tomverbeure/ds1486/ds1486_rp2350/ds1486_rp2350.kicad_pcb

## KiCad design ds1486_rp2350/ds1486_rp2350.kicad_pcb (2025-09-17)

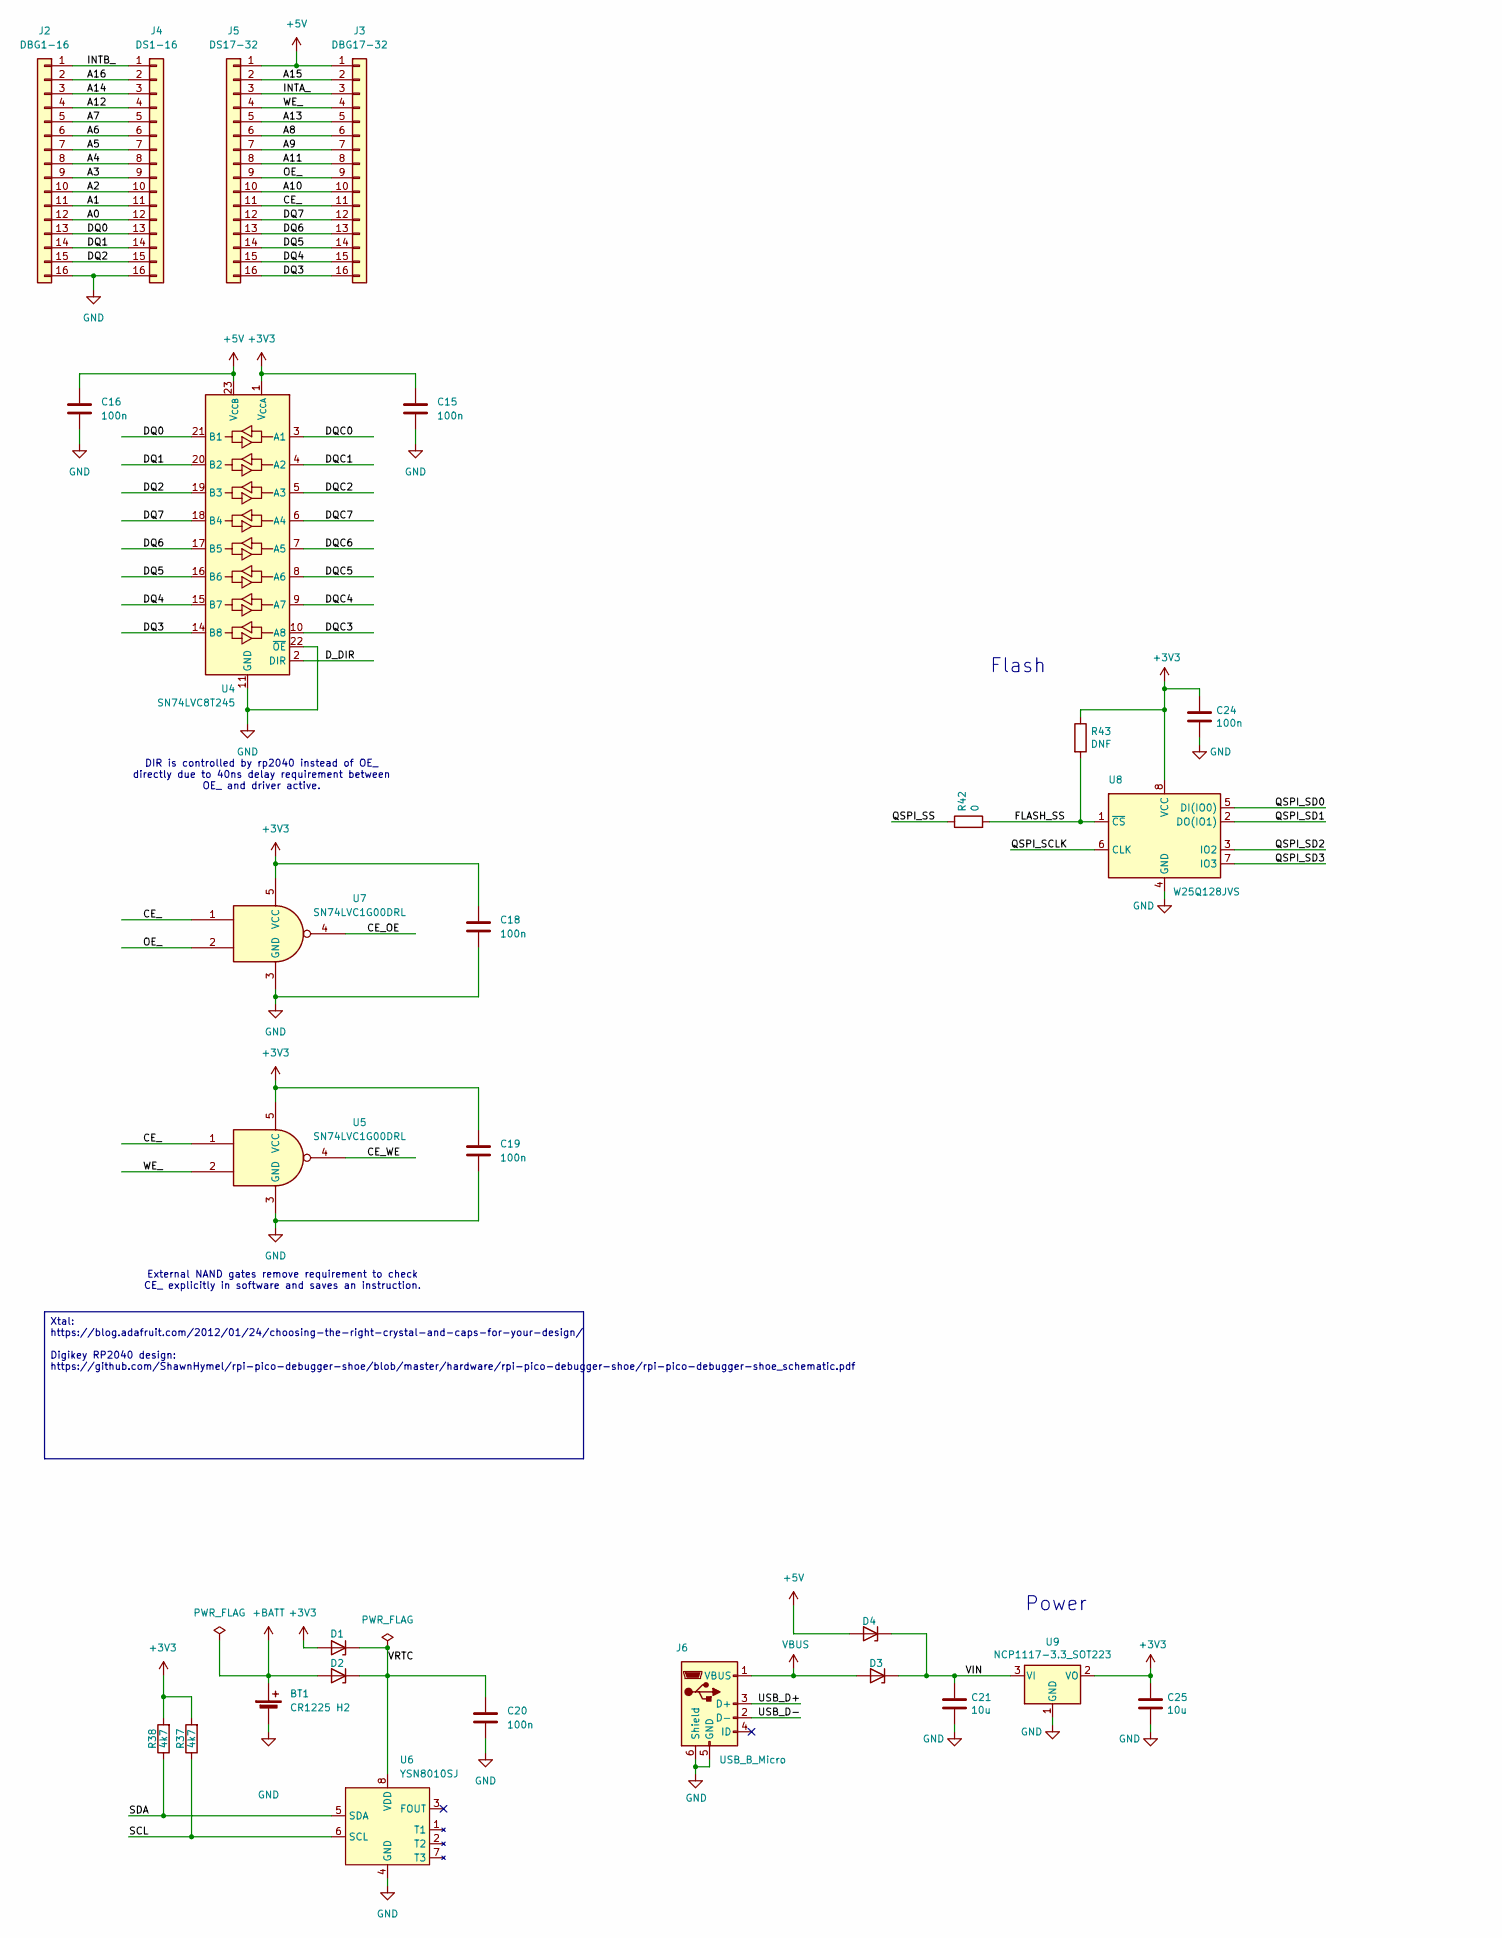
[picture p1: schematic ds1486_rp2350.kicad_sch, part in row 1, column 1]

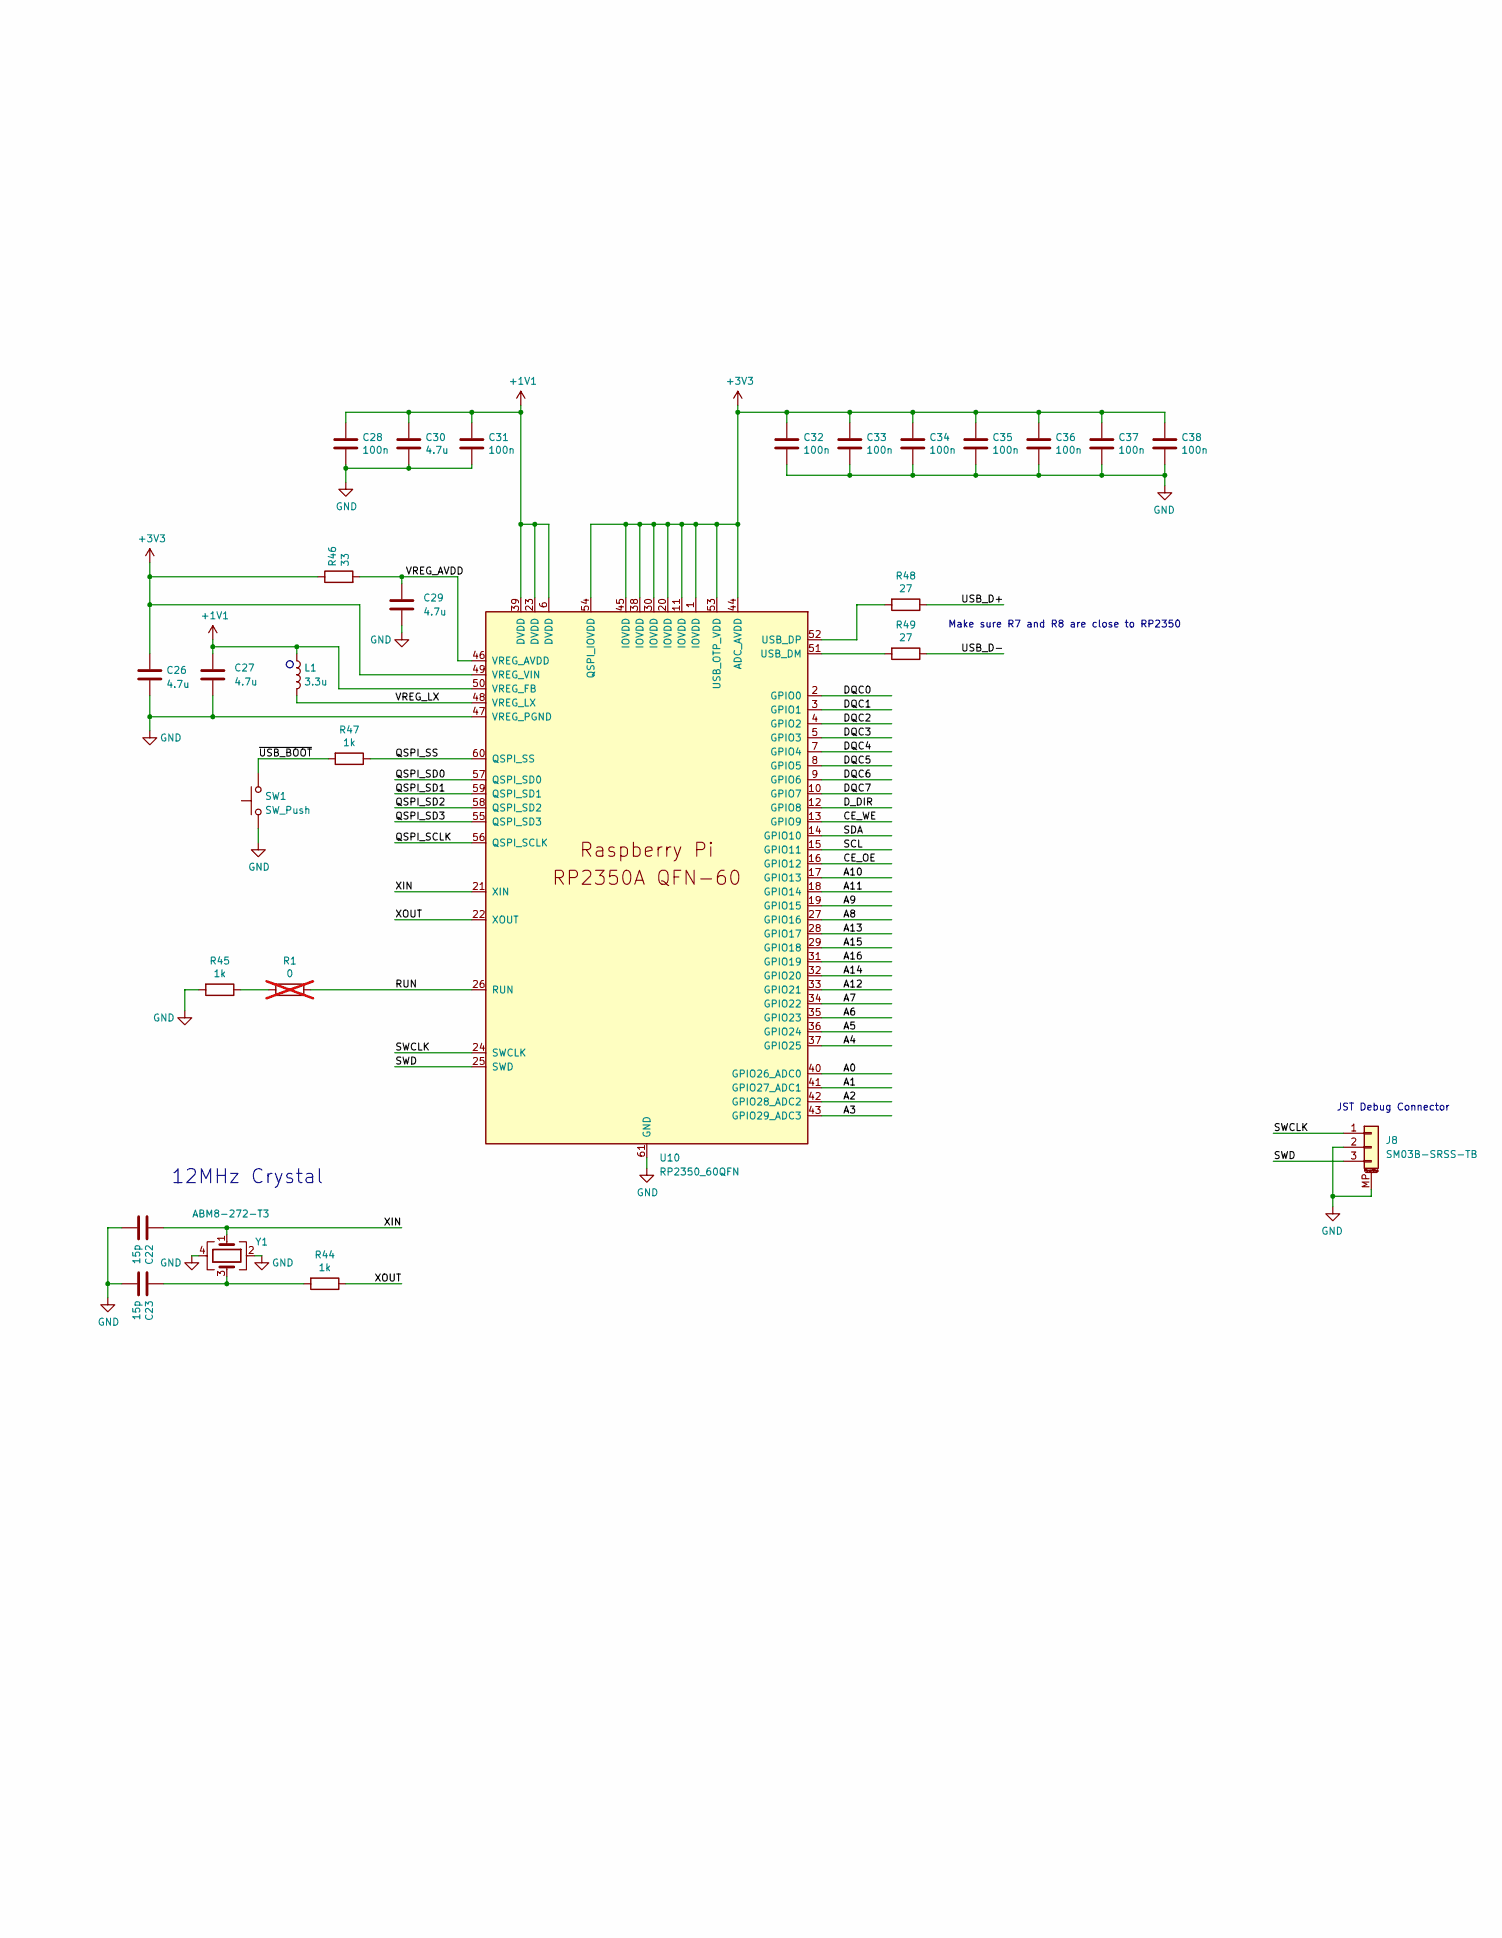
[picture p2: schematic ds1486_rp2350.kicad_sch, part in row 1, column 2]

Parts:
BT1: CR1225 H2; CR1225_H2
C15, C16, C20: 100n; C_0603_1608Metric
C18, C19, C24, C28, C31, C32, C33, C34, C35, C36, C37, C38: 100n; C_0402_1005Metric
C21, C25: 10u; C_0805_2012Metric
C22, C23: 15p; C_0402_1005Metric
C26, C27: 4.7u; C_0402_1005Metric_small_pads
C29, C30: 4.7u; C_0402_1005Metric
D1, D2, D3, D4: BZT52C6V8-7-F; D_SOD-123F
J2: DBG1-16; PinHeader_1x16_P2.54mm_Vertical
J3: DBG17-32; PinHeader_1x16_P2.54mm_Vertical
J4: DS1-16; PinHeader_1x16_P2.54mm_Vertical_DIP_Diameter_Flipside
J5: DS17-32; PinHeader_1x16_P2.54mm_Vertical_DIP_Diameter_Flipside
J6: USB_B_Micro; USB_Micro-B_Amphenol_10103594-0001LF_Horizontal
J8: SM03B-SRSS-TB; JST_SH_SM03B-SRSS-TB_1x03-1MP_P1.00mm_Horizontal
L1: 3.3u; L_pol_2016
R1: 0; R_0402_1005Metric; not fitted
R37, R38: 4k7; R_0402_1005Metric
R42: 0; R_0402_1005Metric
R43: DNF; R_0402_1005Metric
R44, R45, R47: 1k; R_0402_1005Metric
R46: 33; R_0402_1005Metric
R48, R49: 27; R_0402_1005Metric
SW1: SW_Push; SW_Push_1P1T_NO_Vertical_Wuerth_434133025816
U4: SN74LVC8T245; SSOP-24_3.9x8.7mm_P0.635mm
U5, U7: SN74LVC1G00DRL; Texas_R-PDSO-N5_DRL-5
U6: YSN8010SJ; SOP-8_3.9x4.9mm_P1.27mm
U8: W25Q128JVS; SOIC-8_5.23x5.23mm_P1.27mm
U9: NCP1117-3.3_SOT223; SOT-223-3_TabPin2
U10: RP2350_60QFN; QFN-60-1EP_7x7mm_P0.4mm_EP3.4x3.4mm
Y1: ABM8-272-T3; Crystal_SMD_3225-4Pin_3.2x2.5mm

Connections:
+1V1: C27.1, C28.1, C30.1, C31.1, L1.1, U10.6 (DVDD), U10.23 (DVDD), U10.39 (DVDD), U10.50 (VREG_FB)
+3V3: C15.1, C18.1, C19.1, C24.1, C25.1, C26.1, C32.1, C33.1, C34.1, C35.1, C36.1, C37.1, C38.1, D1.2 (A), R37.2, R38.2, R43.1, R46.1, U4.1 (V_{CCA}), U5.5 (VCC), U7.5 (VCC), U8.8 (VCC), U9.2 (VO), U10.1 (IOVDD), U10.11 (IOVDD), U10.20 (IOVDD), U10.30 (IOVDD), U10.38 (IOVDD), U10.44 (ADC_AVDD), U10.45 (IOVDD), U10.49 (VREG_VIN), U10.53 (USB_OTP_VDD), U10.54 (QSPI_IOVDD)
+5V: C16.1, D4.2 (A), J3.1, J5.1, U4.23 (V_{CCB}), U4.24 (V_{CCB})
+BATT: BT1.1 (+), D2.2 (A)
/A0: J2.12, J4.12, U10.40 (GPIO26_ADC0)
/A1: J2.11, J4.11, U10.41 (GPIO27_ADC1)
/A2: J2.10, J4.10, U10.42 (GPIO28_ADC2)
/A3: J2.9, J4.9, U10.43 (GPIO29_ADC3)
/A4: J2.8, J4.8, U10.37 (GPIO25)
/A5: J2.7, J4.7, U10.36 (GPIO24)
/A6: J2.6, J4.6, U10.35 (GPIO23)
/A7: J2.5, J4.5, U10.34 (GPIO22)
/A8: J3.6, J5.6, U10.27 (GPIO16)
/A9: J3.7, J5.7, U10.19 (GPIO15)
/A10: J3.10, J5.10, U10.17 (GPIO13)
/A11: J3.8, J5.8, U10.18 (GPIO14)
/A12: J2.4, J4.4, U10.33 (GPIO21)
/A13: J3.5, J5.5, U10.28 (GPIO17)
/A14: J2.3, J4.3, U10.32 (GPIO20)
/A15: J3.2, J5.2, U10.29 (GPIO18)
/A16: J2.2, J4.2, U10.31 (GPIO19)
/CE_: J3.11, J5.11, U5.1, U7.1
/CE_OE: U7.4, U10.16 (GPIO12)
/CE_WE: U5.4, U10.13 (GPIO9)
/DQ0: J2.13, J4.13, U4.21 (B1)
/DQ1: J2.14, J4.14, U4.20 (B2)
/DQ2: J2.15, J4.15, U4.19 (B3)
/DQ3: J3.16, J5.16, U4.14 (B8)
/DQ4: J3.15, J5.15, U4.15 (B7)
/DQ5: J3.14, J5.14, U4.16 (B6)
/DQ6: J3.13, J5.13, U4.17 (B5)
/DQ7: J3.12, J5.12, U4.18 (B4)
/DQC0: U4.3 (A1), U10.2 (GPIO0)
/DQC1: U4.4 (A2), U10.3 (GPIO1)
/DQC2: U4.5 (A3), U10.4 (GPIO2)
/DQC3: U4.10 (A8), U10.5 (GPIO3)
/DQC4: U4.9 (A7), U10.7 (GPIO4)
/DQC5: U4.8 (A6), U10.8 (GPIO5)
/DQC6: U4.7 (A5), U10.9 (GPIO6)
/DQC7: U4.6 (A4), U10.10 (GPIO7)
/D_DIR: U4.2 (DIR), U10.12 (GPIO8)
/FLASH_SS: R42.2, R43.2, U8.1 (~CS)
/INTA_: J3.3, J5.3
/INTB_: J2.1, J4.1
/OE_: J3.9, J5.9, U7.2
/QSPI_SCLK: U8.6 (CLK), U10.56 (QSPI_SCLK)
/QSPI_SD0: U8.5 (DI(IO0)), U10.57 (QSPI_SD0)
/QSPI_SD1: U8.2 (DO(IO1)), U10.59 (QSPI_SD1)
/QSPI_SD2: U8.3 (IO2), U10.58 (QSPI_SD2)
/QSPI_SD3: U8.7 (IO3), U10.55 (QSPI_SD3)
/QSPI_SS: R42.1, R47.1, U10.60 (QSPI_SS)
/RUN: R1.1, U10.26 (RUN)
/SCL: R37.1, U6.6 (SCL), U10.15 (GPIO11)
/SDA: R38.1, U6.5 (SDA), U10.14 (GPIO10)
/SWCLK: J8.1, U10.24 (SWCLK)
/SWD: J8.3, U10.25 (SWD)
/USB_D+: J6.3 (D+), R48.1
/USB_D-: J6.2 (D-), R49.1
/VIN: C21.1, D3.1 (K), D4.1 (K), U9.3 (VI)
/VREG_AVDD: C29.1, R46.2, U10.46 (VREG_AVDD)
/VREG_LX: L1.2, U10.48 (VREG_LX)
/VRTC: C20.1, D1.1 (K), D2.1 (K), U6.8 (VDD)
/WE_: J3.4, J5.4, U5.2
/XIN: C22.1, U10.21 (XIN), Y1.1
/XOUT: R44.1, U10.22 (XOUT)
/~USB_BOOT: R47.2, SW1.2
GND: BT1.2 (-), C15.2, C16.2, C18.2, C19.2, C20.2, C21.2, C22.2, C23.2, C24.2, C25.2, C26.2, C27.2, C28.2, C29.2, C30.2, C31.2, C32.2, C33.2, C34.2, C35.2, C36.2, C37.2, C38.2, J2.16, J4.16, J6.5 (GND), J6.6 (Shield), J8.2, J8.MP (MountPin), R45.2, SW1.1, U4.11 (GND), U4.12 (GND), U4.13 (GND), U4.22 (~OE), U5.3 (GND), U6.4 (GND), U7.3 (GND), U8.4 (GND), U9.1 (GND), U10.47 (VREG_PGND), U10.61 (GND), Y1.2, Y1.4
unnamed: C23.1, R44.2, Y1.3
unnamed: R1.2, R45.1
unnamed: R49.2, U10.51 (USB_DM)
unnamed: R48.2, U10.52 (USB_DP)
VBUS: D3.2 (A), J6.1 (VBUS)

Notes on the sheet:
Flash
DIR is controlled by rp2040 instead of OE_ directly due to 40ns delay requirement between OE_ and driver active.
External NAND gates remove requirement to check CE_ explicitly in software and saves an instruction.
12MHz Crystal
Make sure R7 and R8 are close to RP2350
Power
JST Debug Connector
Xtal: https://blog.adafruit.com/2012/01/24/choosing-the-right-crystal-and-caps-for-your-design/ Digikey RP2040 design: https://github.com/ShawnHymel/rpi-pico-debugger-shoe/blob/master/hardware/rpi-pico-debugger-shoe/rpi-pico-debugger-shoe_schematic.pdf

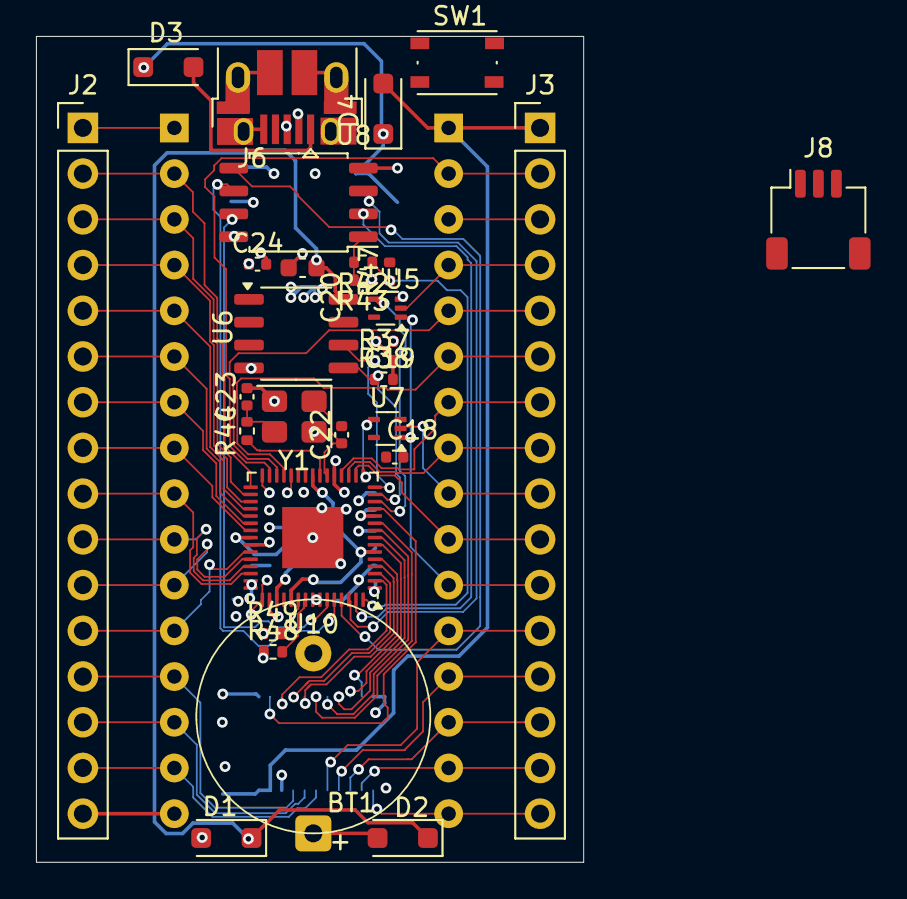
[picture p3: board ds1486_rp2350.kicad_pcb from above]

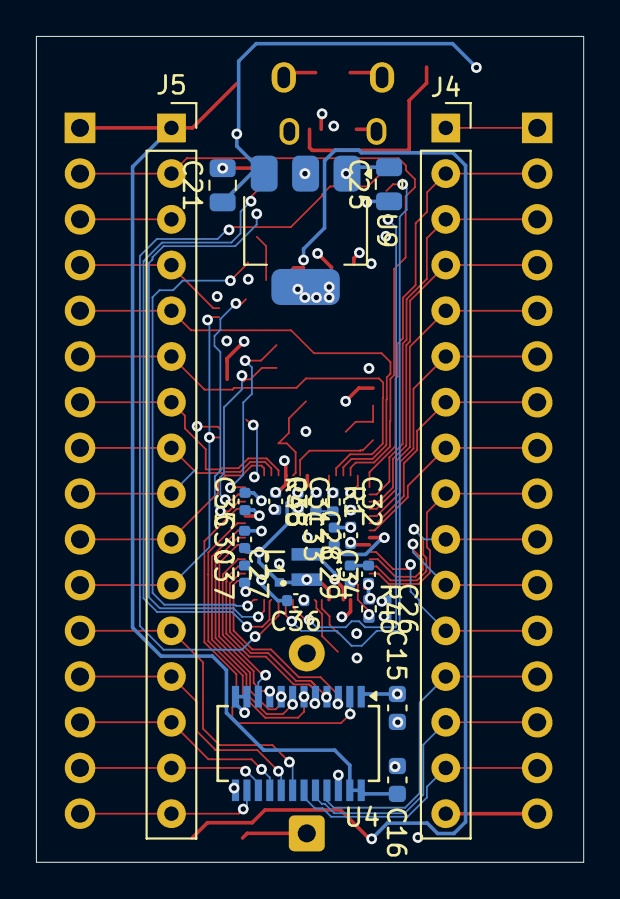
[picture p4: board ds1486_rp2350.kicad_pcb from below]

Board: 4 copper layers, 30.4 x 45.9 mm, 55 parts (23 on the bottom side), 72 nets.
