tomverbeure/ds1486/ds1486/ds1486.kicad_pcb

## KiCad design ds1486/ds1486.kicad_pcb (2025-06-24)

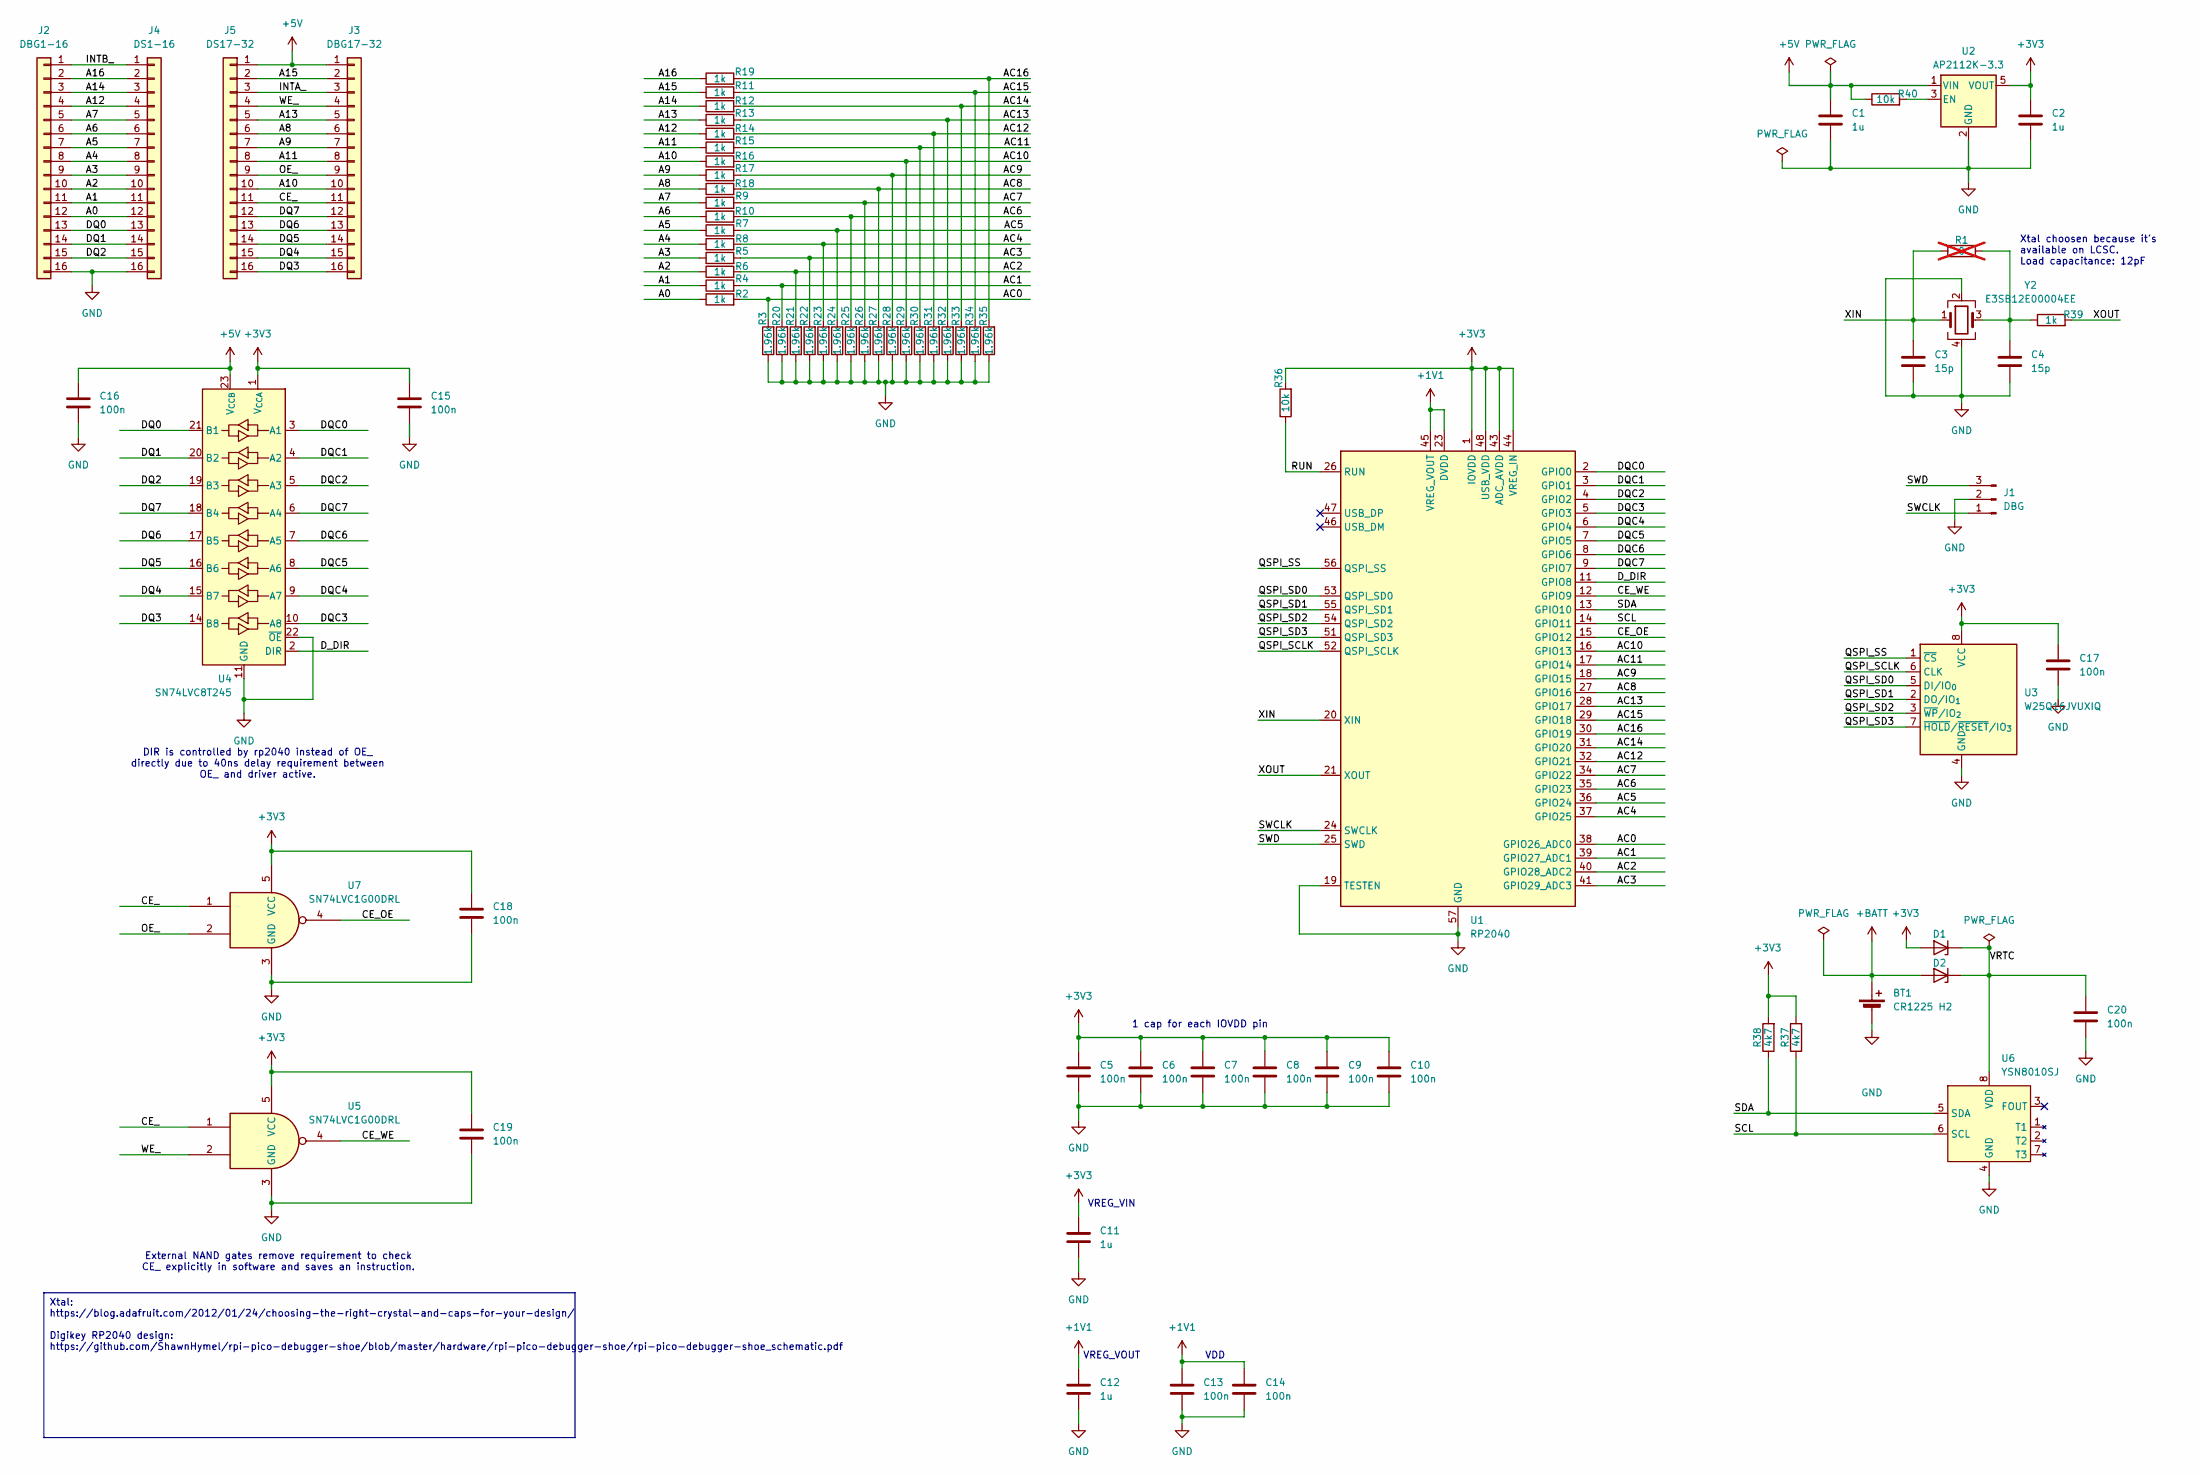
[picture p5: schematic ds1486.kicad_sch]

Parts:
BT1: CR1225 H2; CR1225_H2
C1, C2, C11, C12: 1u; C_0603_1608Metric
C3, C4: 15p; C_0603_1608Metric
C5, C6, C7, C8, C9, C10, C13, C14, C15, C16, C17, C20: 100n; C_0603_1608Metric
C18, C19: 100n; C_0402_1005Metric
D1, D2: BZT52C6V8-7-F; D_SOD-123F
J1: DBG; PinHeader_1x03_P2.54mm_Vertical
J2: DBG1-16; PinHeader_1x16_P2.54mm_Vertical
J3: DBG17-32; PinHeader_1x16_P2.54mm_Vertical
J4: DS1-16; PinHeader_1x16_P2.54mm_Vertical_DIP_Diameter_Flipside
J5: DS17-32; PinHeader_1x16_P2.54mm_Vertical_DIP_Diameter_Flipside
R1: 0; R_0603_1608Metric; not fitted
R2, R4, R5, R6, R7, R8, R9, R10, R11, R12, R13, R14, R15, R16, R17, R18, R19, R39: 1k; R_0402_1005Metric
R3, R20, R21, R22, R23, R24, R25, R26, R27, R28, R29, R30, R31, R32, R33, R34, R35: 1.96k; R_0402_1005Metric
R36, R40: 10k; R_0402_1005Metric
R37, R38: 4k7; R_0603_1608Metric
U1: RP2040; QFN-56-1EP_7x7mm_P0.4mm_EP3.2x3.2mm
U2: AP2112K-3.3; SOT-23-5
U3: W25Q16JVUXIQ; Winbond_USON-8-1EP_3x2mm_P0.5mm_EP0.2x1.6mm
U4: SN74LVC8T245; SSOP-24_3.9x8.7mm_P0.635mm
U5, U7: SN74LVC1G00DRL; Texas_R-PDSO-N5_DRL-5
U6: YSN8010SJ; SOP-8_3.9x4.9mm_P1.27mm
Y2: E3SB12E00004EE; Crystal_SMD_3225-4Pin_3.2x2.5mm

Connections:
+1V1: C12.1, C13.1, C14.1, U1.23 (DVDD), U1.45 (VREG_VOUT), U1.50 (DVDD)
+3V3: C2.1, C5.1, C6.1, C7.1, C8.1, C9.1, C10.1, C11.1, C15.1, C17.1, C18.1, C19.1, D1.2 (A), R36.2, R37.2, R38.2, U1.1 (IOVDD), U1.10 (IOVDD), U1.22 (IOVDD), U1.33 (IOVDD), U1.42 (IOVDD), U1.43 (ADC_AVDD), U1.44 (VREG_IN), U1.48 (USB_VDD), U1.49 (IOVDD), U2.5 (VOUT), U3.8 (VCC), U4.1 (V_{CCA}), U5.5 (VCC), U7.5 (VCC)
+5V: C1.1, C16.1, J3.1, J5.1, R40.1, U2.1 (VIN), U4.23 (V_{CCB}), U4.24 (V_{CCB})
+BATT: BT1.1 (+), D2.2 (A)
/A0: J2.12, J4.12, R2.1
/A1: J2.11, J4.11, R4.1
/A2: J2.10, J4.10, R6.1
/A3: J2.9, J4.9, R5.1
/A4: J2.8, J4.8, R8.1
/A5: J2.7, J4.7, R7.1
/A6: J2.6, J4.6, R10.1
/A7: J2.5, J4.5, R9.1
/A8: J3.6, J5.6, R18.1
/A9: J3.7, J5.7, R17.1
/A10: J3.10, J5.10, R16.1
/A11: J3.8, J5.8, R15.1
/A12: J2.4, J4.4, R14.1
/A13: J3.5, J5.5, R13.1
/A14: J2.3, J4.3, R12.1
/A15: J3.2, J5.2, R11.1
/A16: J2.2, J4.2, R19.1
/AC0: R2.2, R3.2, U1.38 (GPIO26_ADC0)
/AC1: R4.2, R20.2, U1.39 (GPIO27_ADC1)
/AC2: R6.2, R21.2, U1.40 (GPIO28_ADC2)
/AC3: R5.2, R22.2, U1.41 (GPIO29_ADC3)
/AC4: R8.2, R23.2, U1.37 (GPIO25)
/AC5: R7.2, R24.2, U1.36 (GPIO24)
/AC6: R10.2, R25.2, U1.35 (GPIO23)
/AC7: R9.2, R26.2, U1.34 (GPIO22)
/AC8: R18.2, R27.2, U1.27 (GPIO16)
/AC9: R17.2, R28.2, U1.18 (GPIO15)
/AC10: R16.2, R29.2, U1.16 (GPIO13)
/AC11: R15.2, R30.2, U1.17 (GPIO14)
/AC12: R14.2, R31.2, U1.32 (GPIO21)
/AC13: R13.2, R32.2, U1.28 (GPIO17)
/AC14: R12.2, R33.2, U1.31 (GPIO20)
/AC15: R11.2, R34.2, U1.29 (GPIO18)
/AC16: R19.2, R35.2, U1.30 (GPIO19)
/CE_: J3.11, J5.11, U5.1, U7.1
/CE_OE: U1.15 (GPIO12), U7.4
/CE_WE: U1.12 (GPIO9), U5.4
/DQ0: J2.13, J4.13, U4.21 (B1)
/DQ1: J2.14, J4.14, U4.20 (B2)
/DQ2: J2.15, J4.15, U4.19 (B3)
/DQ3: J3.16, J5.16, U4.14 (B8)
/DQ4: J3.15, J5.15, U4.15 (B7)
/DQ5: J3.14, J5.14, U4.16 (B6)
/DQ6: J3.13, J5.13, U4.17 (B5)
/DQ7: J3.12, J5.12, U4.18 (B4)
/DQC0: U1.2 (GPIO0), U4.3 (A1)
/DQC1: U1.3 (GPIO1), U4.4 (A2)
/DQC2: U1.4 (GPIO2), U4.5 (A3)
/DQC3: U1.5 (GPIO3), U4.10 (A8)
/DQC4: U1.6 (GPIO4), U4.9 (A7)
/DQC5: U1.7 (GPIO5), U4.8 (A6)
/DQC6: U1.8 (GPIO6), U4.7 (A5)
/DQC7: U1.9 (GPIO7), U4.6 (A4)
/D_DIR: U1.11 (GPIO8), U4.2 (DIR)
/INTA_: J3.3, J5.3
/INTB_: J2.1, J4.1
/OE_: J3.9, J5.9, U7.2
/QSPI_SCLK: U1.52 (QSPI_SCLK), U3.6 (CLK)
/QSPI_SD0: U1.53 (QSPI_SD0), U3.5 (DI/IO_{0})
/QSPI_SD1: U1.55 (QSPI_SD1), U3.2 (DO/IO_{1})
/QSPI_SD2: U1.54 (QSPI_SD2), U3.3 (~WP/IO_{2})
/QSPI_SD3: U1.51 (QSPI_SD3), U3.7 (~HOLD/~RESET/IO_{3})
/QSPI_SS: U1.56 (QSPI_SS), U3.1 (~CS)
/RUN: R36.1, U1.26 (RUN)
/SCL: R37.1, U1.14 (GPIO11), U6.6 (SCL)
/SDA: R38.1, U1.13 (GPIO10), U6.5 (SDA)
/SWCLK: J1.1, U1.24 (SWCLK)
/SWD: J1.3, U1.25 (SWD)
/VRTC: C20.1, D1.1 (K), D2.1 (K), U6.8 (VDD)
/WE_: J3.4, J5.4, U5.2
/XIN: C3.1, R1.1, U1.20 (XIN), Y2.1
/XOUT: R39.2, U1.21 (XOUT)
GND: BT1.2 (-), C1.2, C2.2, C3.2, C4.2, C5.2, C6.2, C7.2, C8.2, C9.2, C10.2, C11.2, C12.2, C13.2, C14.2, C15.2, C16.2, C17.2, C18.2, C19.2, C20.2, J1.2, J2.16, J4.16, R3.1, R20.1, R21.1, R22.1, R23.1, R24.1, R25.1, R26.1, R27.1, R28.1, R29.1, R30.1, R31.1, R32.1, R33.1, R34.1, R35.1, U1.19 (TESTEN), U1.57 (GND), U2.2 (GND), U3.4 (GND), U4.11 (GND), U4.12 (GND), U4.13 (GND), U4.22 (~OE), U5.3 (GND), U6.4 (GND), U7.3 (GND), Y2.2, Y2.4
unnamed: C4.1, R1.2, R39.1, Y2.3
unnamed: R40.2, U2.3 (EN)

Notes on the sheet:
VDD
VREG_VOUT
DIR is controlled by rp2040 instead of OE_ directly due to 40ns delay requirement between OE_ and driver active.
Xtal choosen because it's available on LCSC. Load capacitance: 12pF
External NAND gates remove requirement to check CE_ explicitly in software and saves an instruction.
1 cap for each IOVDD pin
VREG_VIN
Xtal: https://blog.adafruit.com/2012/01/24/choosing-the-right-crystal-and-caps-for-your-design/ Digikey RP2040 design: https://github.com/ShawnHymel/rpi-pico-debugger-shoe/blob/master/hardware/rpi-pico-debugger-shoe/rpi-pico-debugger-shoe_schematic.pdf

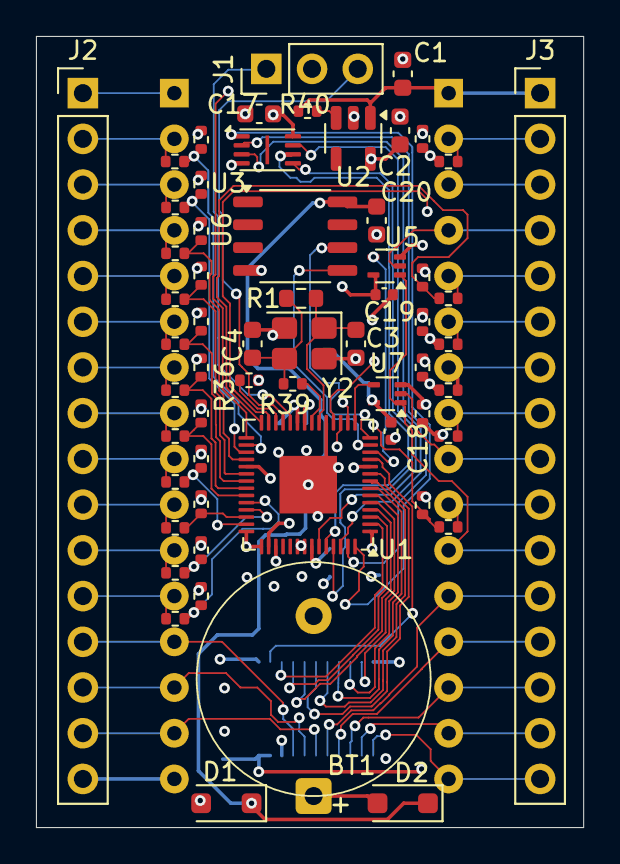
[picture p6: board ds1486.kicad_pcb from above]

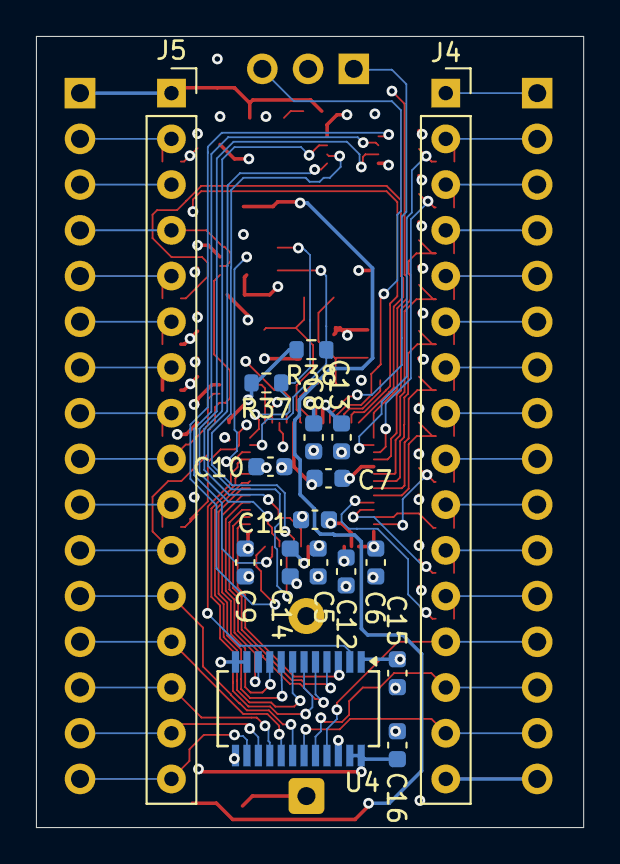
[picture p7: board ds1486.kicad_pcb from below]

Board: 4 copper layers, 30.4 x 43.9 mm, 76 parts (15 on the bottom side), 79 nets.
