tomverbeure/ds1486/(commit log)

2025-05-27 PCB without RTC and battery.
    [ds1486.kicad_pcb, ds1486.kicad_sch]
2025-06-06 Add RTC.
    [ds1486.kicad_pcb, ds1486.kicad_sch]
2025-06-07 Add battery and narrow pin header.
    [ds1486.kicad_pcb, ds1486.kicad_sch]
2025-06-12 Fully routed.
    [ds1486.kicad_pcb, ds1486.kicad_sch]
2025-06-23 Add some decoupling caps. Gerbers.
    [ds1486.kicad_pcb, ds1486.kicad_sch]
2025-06-24 Move VRTC and SPI flash to front layer.
    [ds1486.kicad_pcb, ds1486.kicad_sch]
2025-06-24 Move D_DIR.
    [ds1486.kicad_pcb, ds1486.kicad_sch]
2025-06-24 Remove old W25Q16.
    [ds1486.kicad_pcb, ds1486.kicad_sch]
2025-09-17 ds1486-rp2350 first version.
    [ds1486_rp2350.kicad_pcb, ds1486_rp2350.kicad_sch]
